Motoguzzi391/main_project/Jeff/Report/Robotics_Control/Screenshots/gripper.PNG

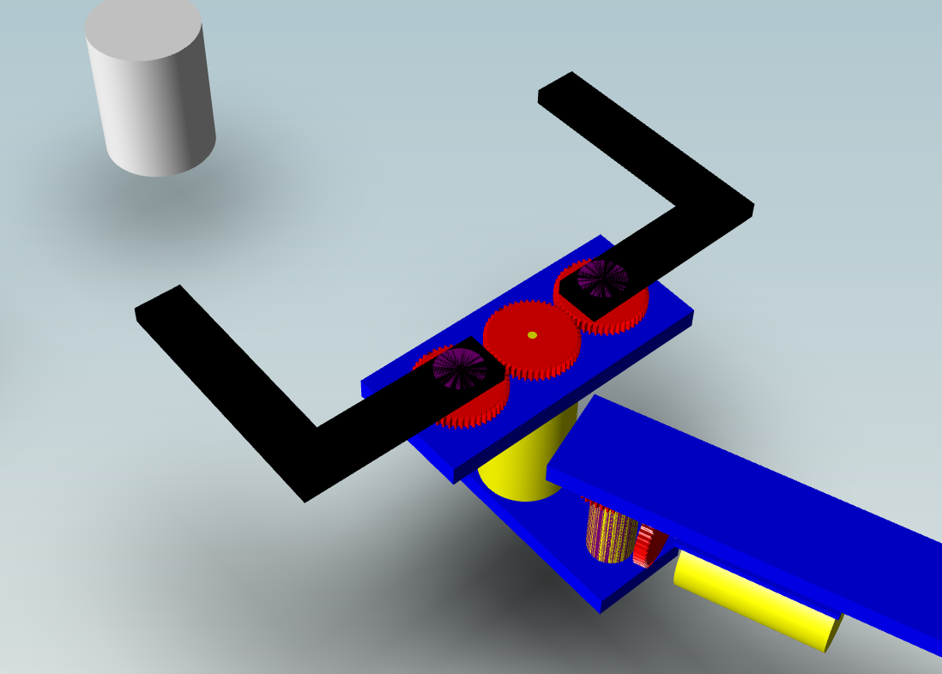
Jeff/Report/Robotics_Control/Screenshots/gripper.PNG
