Motoguzzi391/main_project/Jeff/Report/Robotics_Control/Screenshots/3.PNG

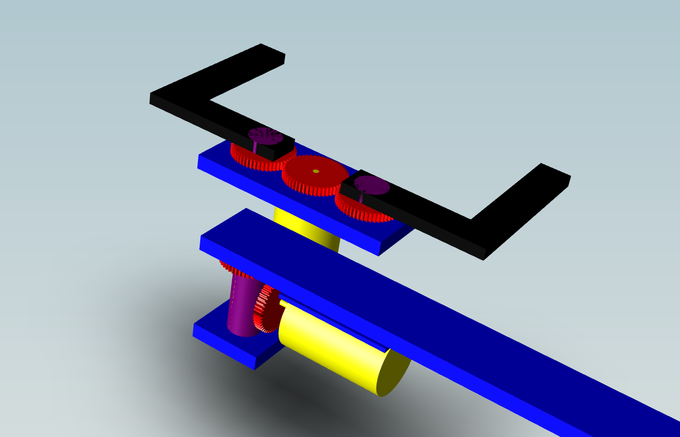
Jeff/Report/Robotics_Control/Screenshots/3.PNG
