Motoguzzi391/main_project/Jeff/Report/Robotics_Control/Screenshots/2.PNG

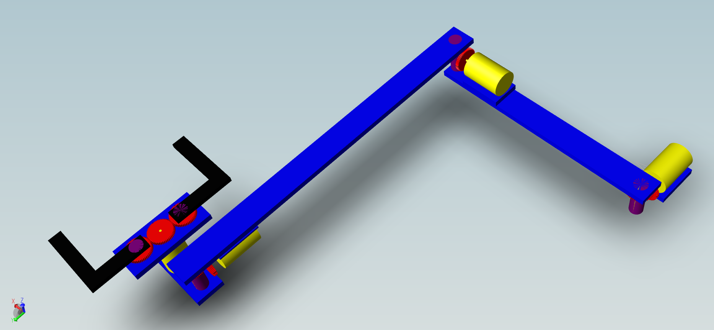
Jeff/Report/Robotics_Control/Screenshots/2.PNG
