Motoguzzi391/main_project/Jeff/Report/Robotics_Control/Screenshots/Screen Shot 2021-04-13 at 8.36.03 PM.png

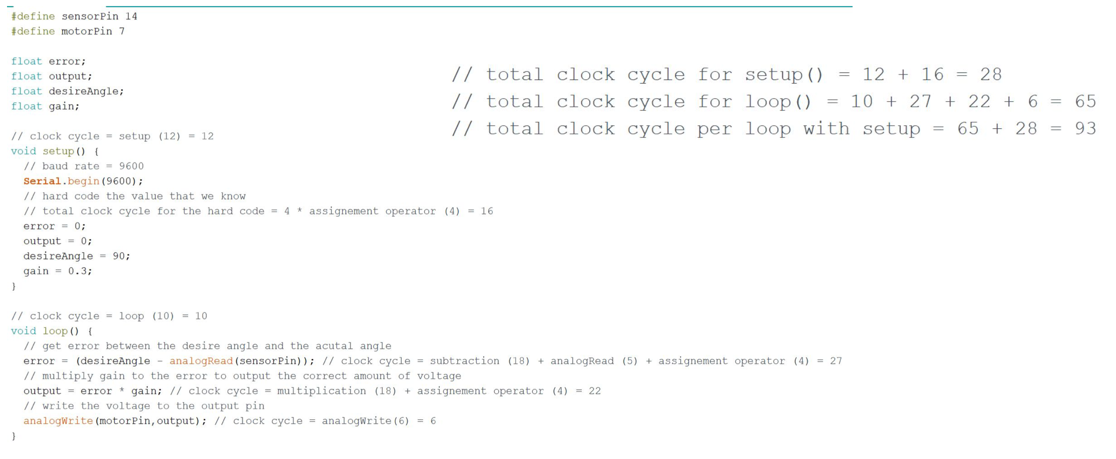
Jeff/Report/Robotics_Control/Screenshots/Screen Shot 2021-04-13 at 8.36.03 PM.png
