Motoguzzi391/main_project/Mark/elec/Driver_Circuit.jpg

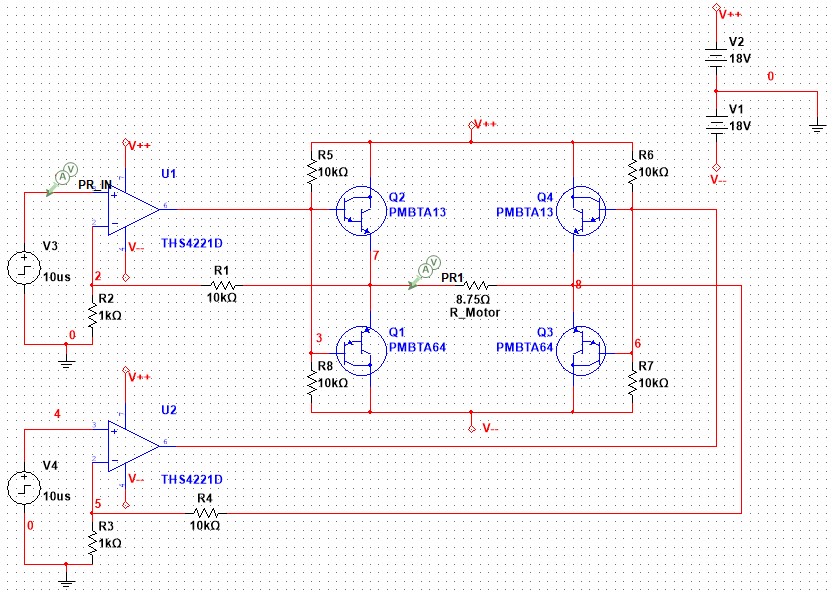
Mark/elec/Driver_Circuit.jpg
