Motoguzzi391/main_project/Mark/elec/Negative_Transient_Differential.jpg

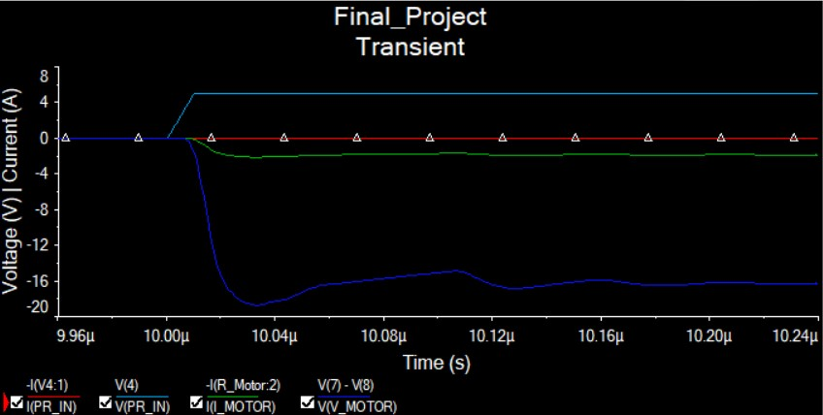
Mark/elec/Negative_Transient_Differential.jpg
