Motoguzzi391/main_project/Mark/elec/PCB_2D_View.jpg

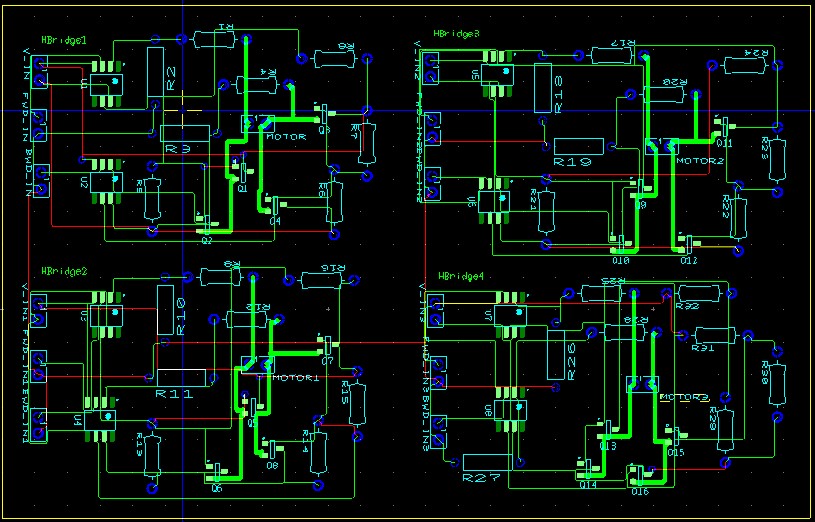
Mark/elec/PCB_2D_View.jpg
