Motoguzzi391/main_project/Mark/elec/PCB_3D_View.jpg

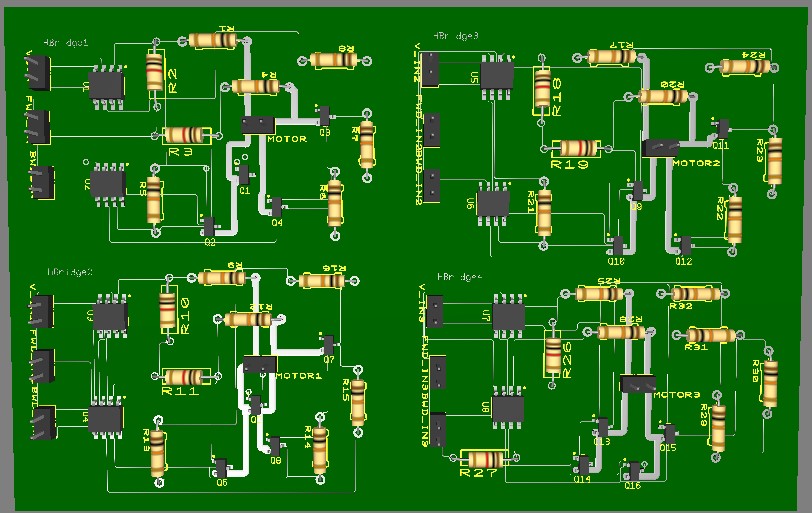
Mark/elec/PCB_3D_View.jpg
