Motoguzzi391/main_project/Mark/elec/Positive_Transient.jpg

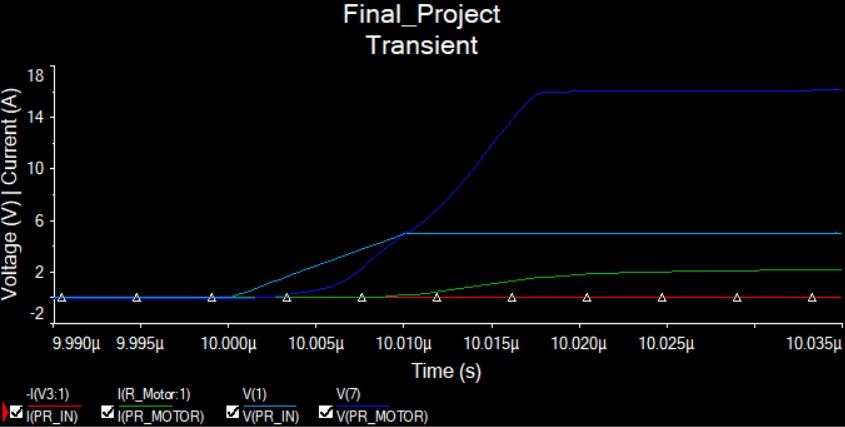
Mark/elec/Positive_Transient.jpg
