Motoguzzi391/main_project/Mark/elec/Transfer_Function.jpg

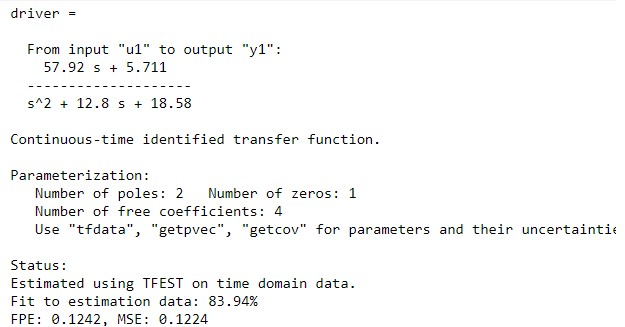
Mark/elec/Transfer_Function.jpg
