Motoguzzi391/main_project/Mark/mech/Maxon_Catalog_18V_Motor.jpg

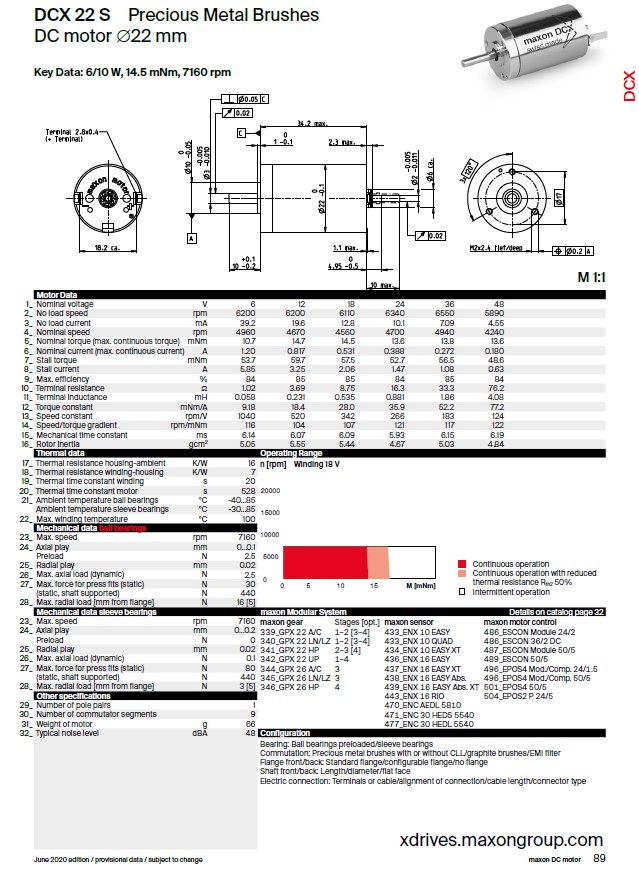
Mark/mech/Maxon_Catalog_18V_Motor.jpg
