Motoguzzi391/main_project/Jeff/Solidworks/gripper/assem1.SLDASM

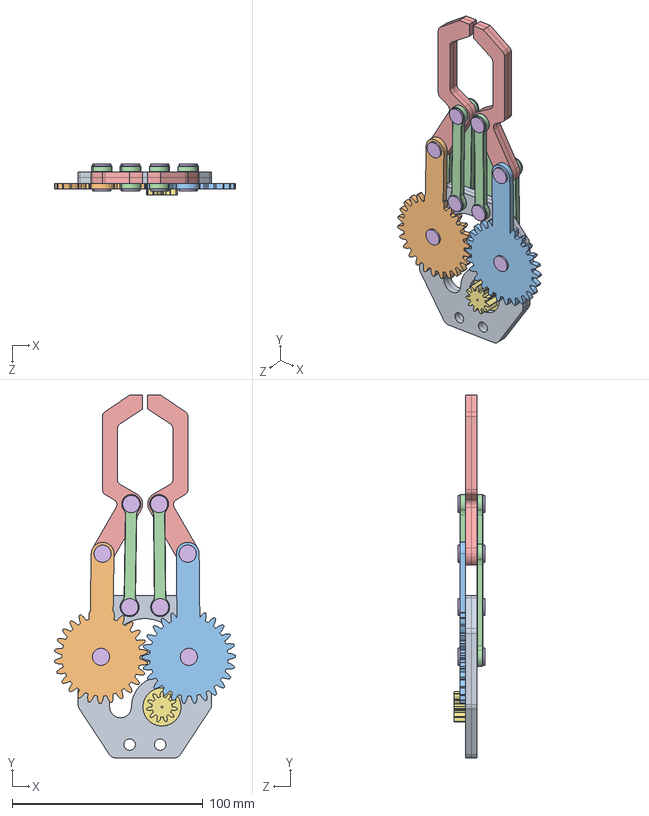
[picture p77: CAD file, 2021-04-15]
Jeff/Solidworks/gripper/assem1.SLDASM
94.9 x 190.1 x 16.0 mm
new_gear1
new_gear
joint1 x 6
joint2 x 8
final-special_gear
