Motoguzzi391/main_project/Grace/final-special_gear.SLDPRT

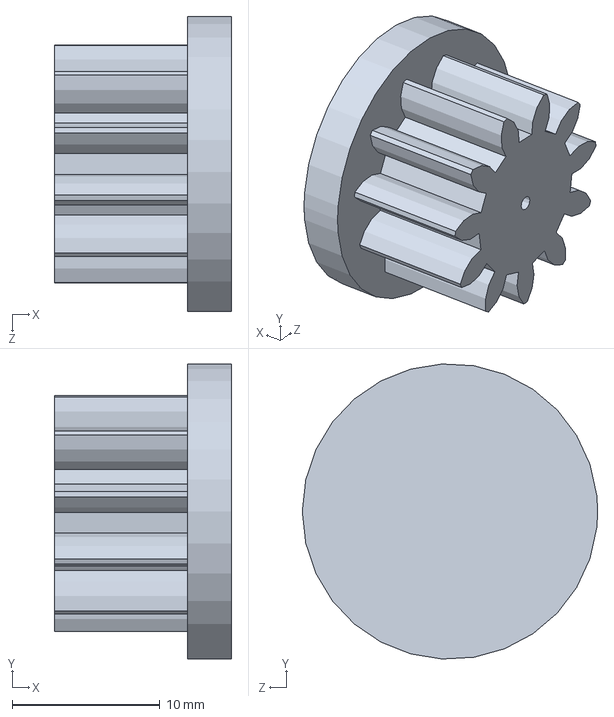
[picture p78: CAD file, 2021-04-15]
Grace/final-special_gear.SLDPRT
12.0 x 20.0 x 20.0 mm
