Motoguzzi391/main_project/Jeff/Solidworks/gripper/gripper - joint2-6.STL

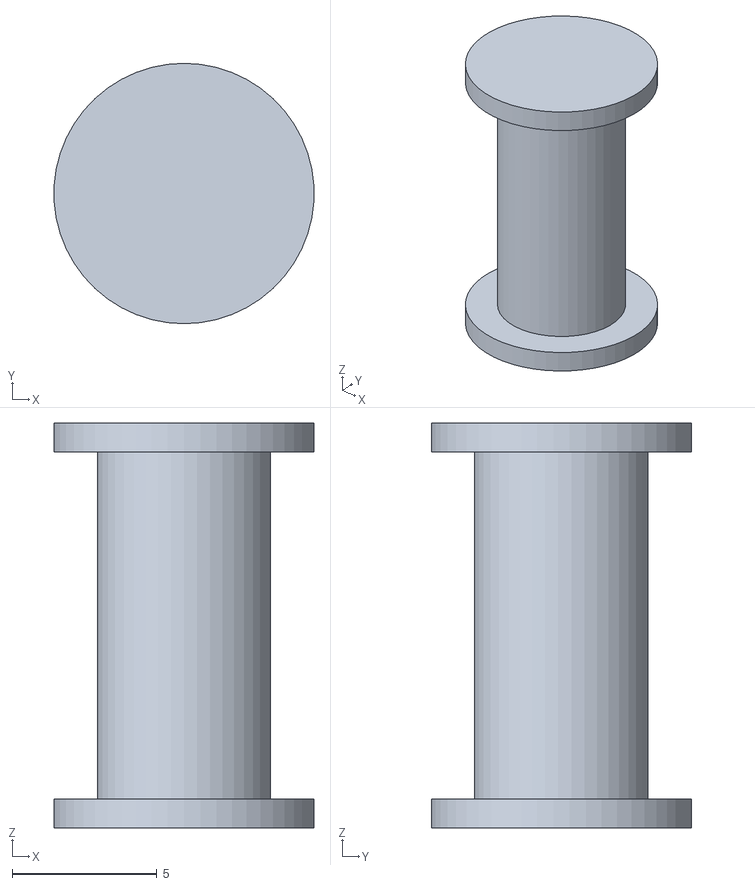
[picture p79: CAD file, 2021-04-15]
Jeff/Solidworks/gripper/gripper - joint2-6.STL
8.98 x 9.00 x 14.0
