Motoguzzi391/main_project/Mark/elec/Ultiboard_CAD_Export.dxf

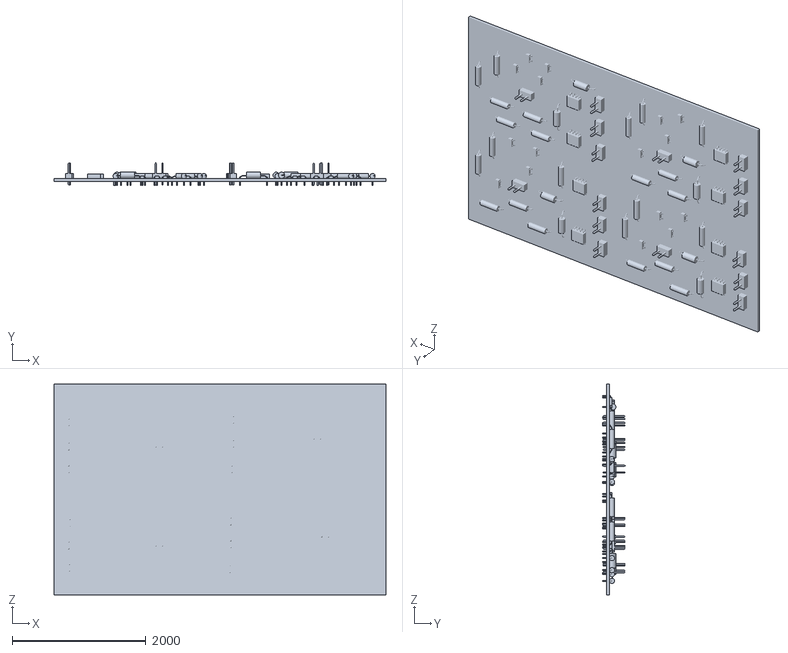
[picture p80: CAD file, 2021-04-15]
Mark/elec/Ultiboard_CAD_Export.dxf
4960.1 x 336.6 x 3150.0
