Motoguzzi391/main_project/Mark/mech/Motor_Model.stp

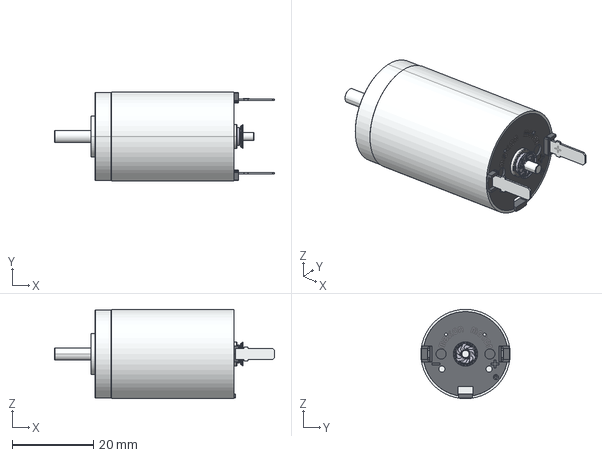
[picture p81: CAD file, 2021-04-15]
Mark/mech/Motor_Model.stp
54.2 x 22.0 x 22.0 mm
