Motoguzzi391/main_project/Grace/joint1.SLDPRT

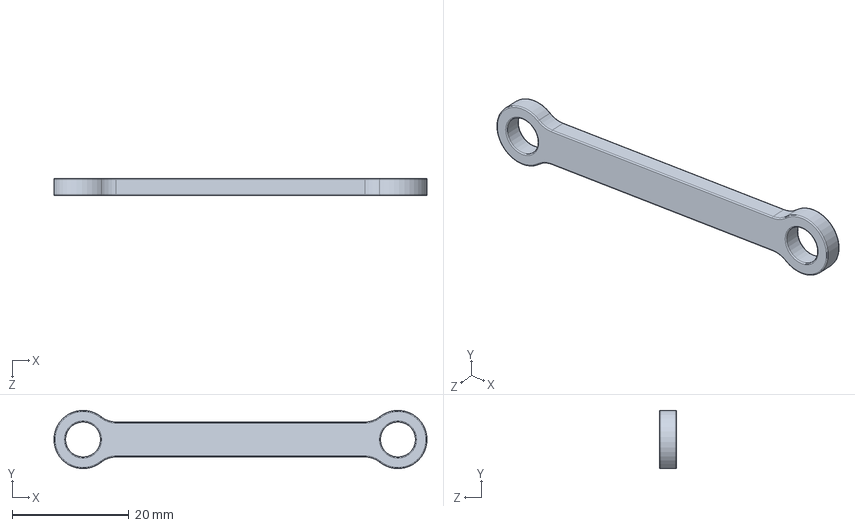
[picture p82: CAD file, 2021-04-15]
Grace/joint1.SLDPRT
64.0 x 9.99 x 3.00 mm
