Motoguzzi391/main_project/Mark/mech/Arduino Leonardo.STEP

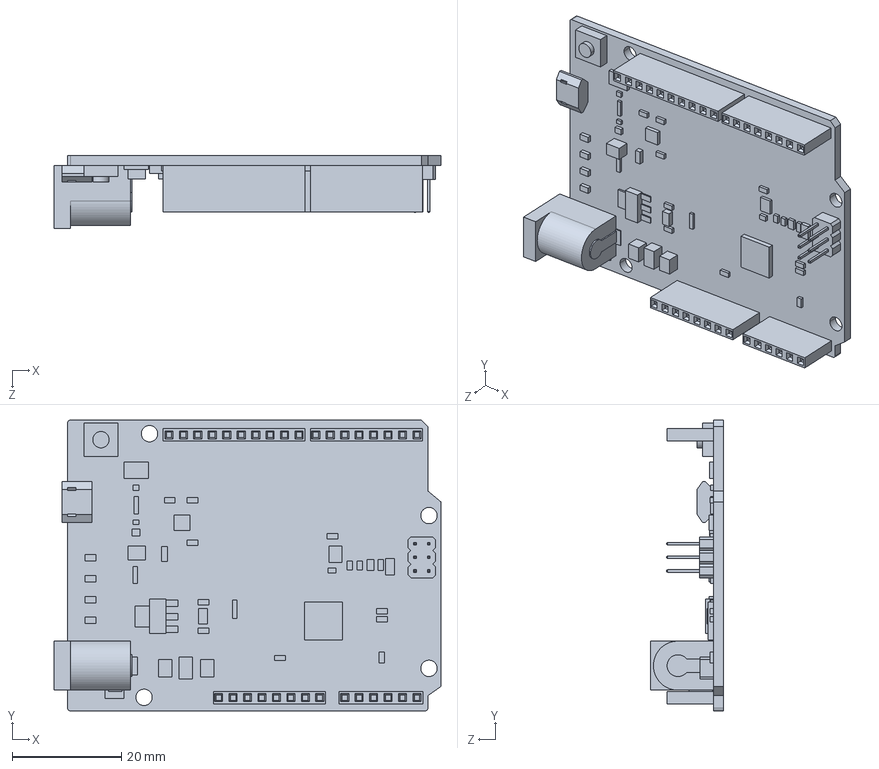
[picture p83: CAD file, 2021-04-15]
Mark/mech/Arduino Leonardo.STEP
70.9 x 53.3 x 13.3 mm
