Motoguzzi391/main_project/Grace/new_gear1.SLDPRT

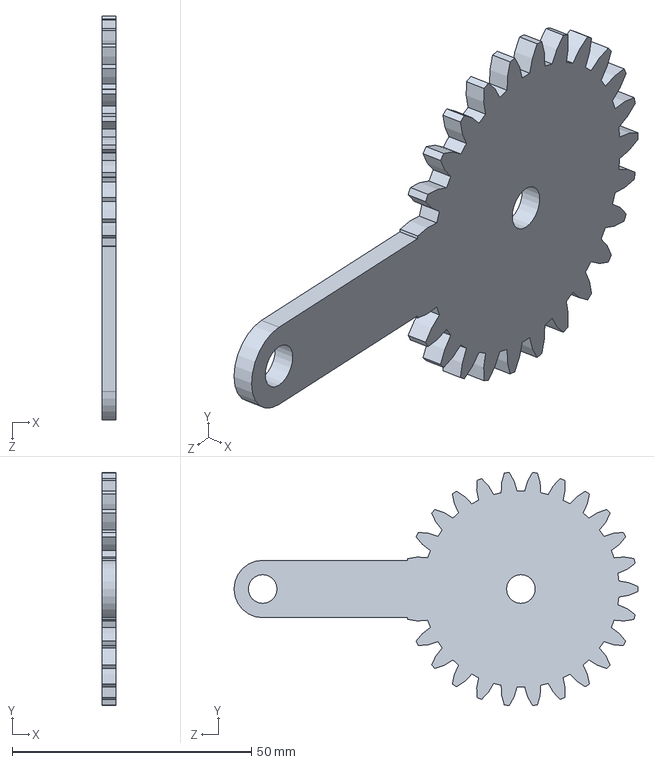
[picture p84: CAD file, 2021-04-15]
Grace/new_gear1.SLDPRT
3.00 x 48.8 x 84.5 mm
