Motoguzzi391/main_project/Jeff/Solidworks/gripper/gripper - spur gear_iso-1.STL

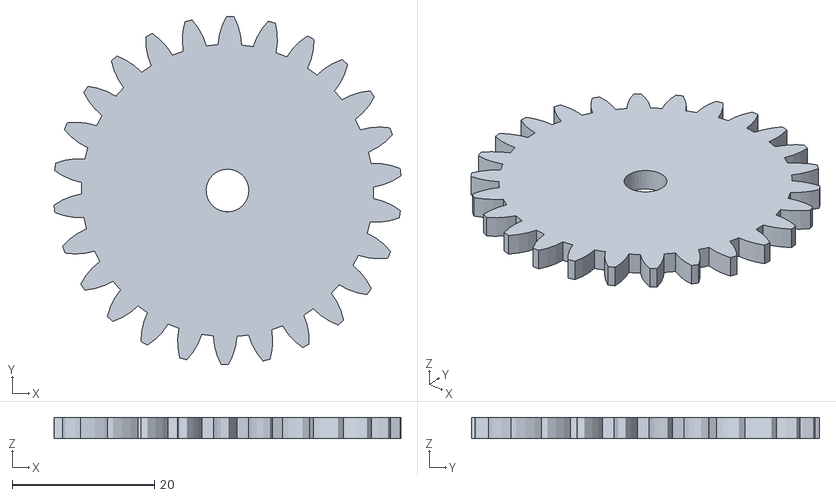
[picture p85: CAD file, 2021-04-15]
Jeff/Solidworks/gripper/gripper - spur gear_iso-1.STL
48.8 x 49.0 x 3.00
