Motoguzzi391/main_project/Grace/Part1.SLDPRT

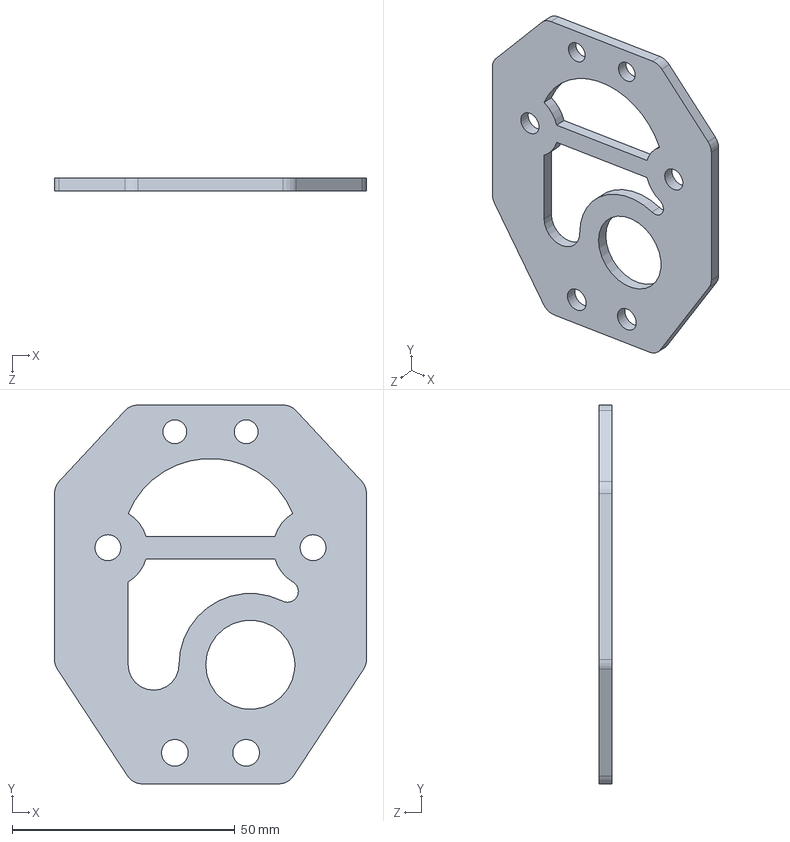
[picture p86: CAD file, 2021-04-15]
Grace/Part1.SLDPRT
70.0 x 85.0 x 3.00 mm
