Motoguzzi391/main_project/Jeff/Solidworks/gripper/gripper - joint1-6.STL

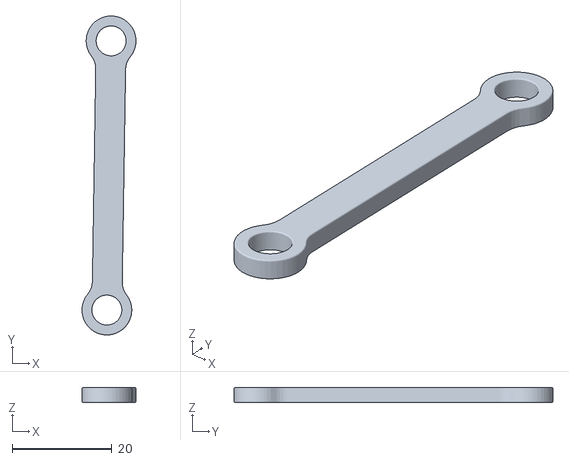
[picture p87: CAD file, 2021-04-15]
Jeff/Solidworks/gripper/gripper - joint1-6.STL
10.8 x 64.0 x 3.00
