Motoguzzi391/main_project/Grace/Part2.SLDPRT

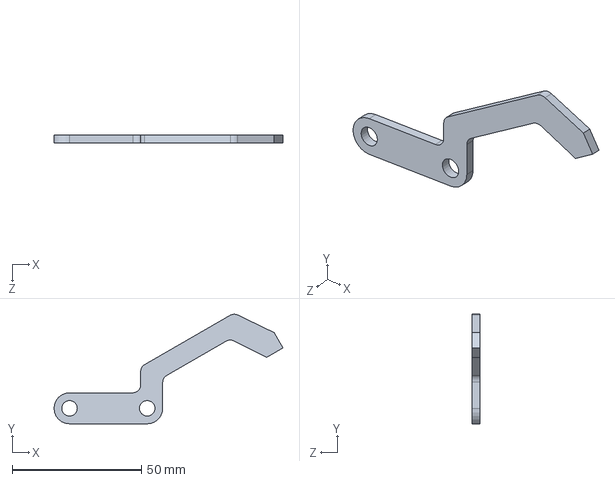
[picture p88: CAD file, 2021-04-15]
Grace/Part2.SLDPRT
88.5 x 42.4 x 3.00 mm
