Motoguzzi391/main_project/Jeff/Solidworks/gripper/gripper - Part2-5.STL

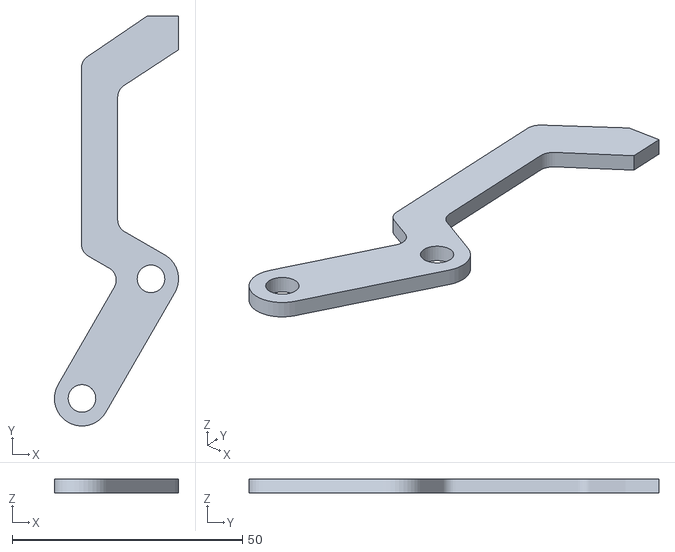
[picture p89: CAD file, 2021-04-15]
Jeff/Solidworks/gripper/gripper - Part2-5.STL
27.0 x 89.1 x 3.00
