Motoguzzi391/main_project/Jeff/Solidworks/gripper/gripper - spur gear_iso-4.STL

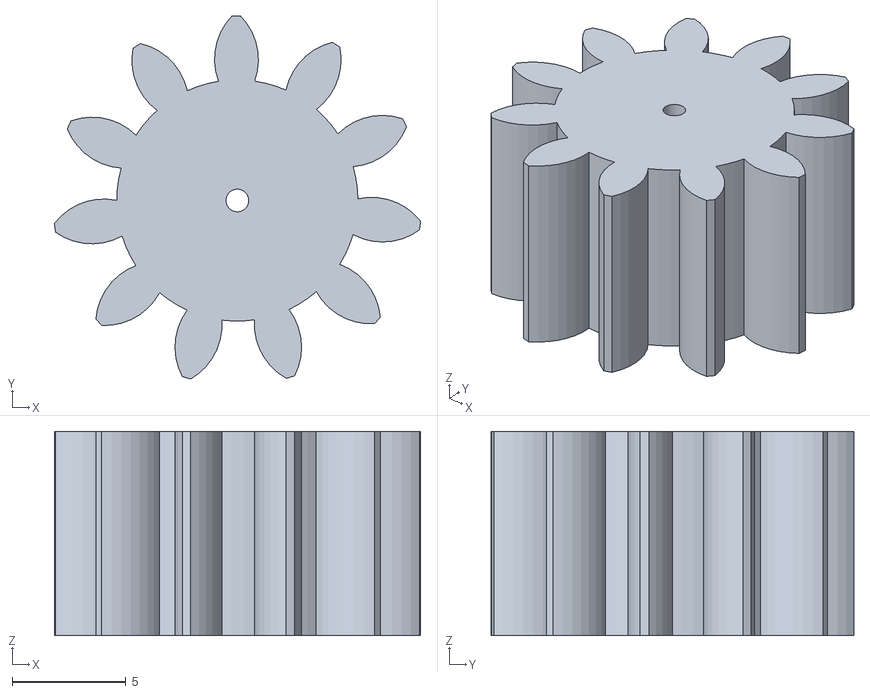
[picture p90: CAD file, 2021-04-15]
Jeff/Solidworks/gripper/gripper - spur gear_iso-4.STL
16.1 x 16.0 x 9.00
