Motoguzzi391/main_project/(list of files, cad)

Other CAD files:
Grace/joint2.SLDPRT
Jeff/Solidworks/gripper/joint2.SLDPRT
Grace/new_gear.SLDPRT
Jeff/Solidworks/gripper/gripper - joint1-4.STL
Jeff/Solidworks/gripper/gripper - joint2-3.STL
Jeff/Solidworks/gripper/gripper - Part1-2.STL
Jeff/Solidworks/gripper/gripper - Part2-6.STL
Jeff/Solidworks/gripper/gripper - joint1-3.STL
Jeff/Solidworks/gripper/gripper - joint2-7.STL
Jeff/Solidworks/gripper/gripper - joint1-2.STL
Jeff/Solidworks/gripper/gripper - joint2-5.STL
Jeff/Solidworks/gripper/gripper - Part2-7.STL
Jeff/Solidworks/gripper/gripper - joint2-9.STL
Jeff/Solidworks/gripper/new_gear.SLDPRT
Jeff/Solidworks/gripper/gripper - Part2-4.STL
Jeff/Solidworks/gripper/gripper - Part1-1.STL
Jeff/Solidworks/gripper/gripper - spur gear_iso-3.STL
Jeff/Solidworks/gripper/gripper - joint2-1.STL
Jeff/Solidworks/gripper/gripper - joint1-5.STL
Jeff/Solidworks/gripper/gripper - joint2-8.STL
Jeff/Solidworks/gripper/gripper - joint1-1.STL
Jeff/Solidworks/gripper/gripper - joint2-4.STL
