Motoguzzi391/main_project/Mark/elec/Driver_Circuit.pdf

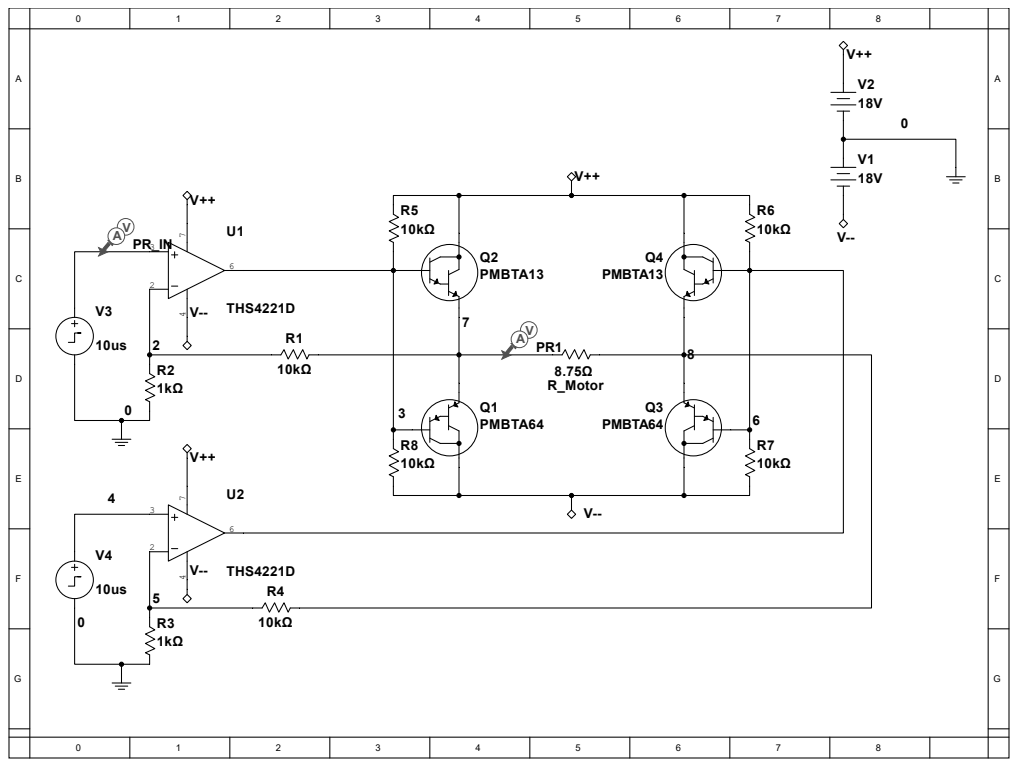
[picture p92: page 1]
