Motoguzzi391/main_project/(list of files, drawings)

Other design files:
Mark/elec/Final_Project.ms14
Mark/elec/Final_Project_PCB.ms14
