Motoguzzi391/main_project/(commit log)

2021-03-25 Robot Kinematics: Inverse Kinematics
    [Motor_pos.xlsx]
2021-04-08 motor specs & basic circuit
    [Arduino Leonardo.STEP, Driver_Circuit.ms14, HBridge.ms14, Jeff_Circuit.ms14, MOS_HBridge.ms14, Motor_Model.stp]
2021-04-08 h-bridge improvement and Tfest
    [Driver_Circuit.ms14, Final_Project.ms14, HBridge.ms14, Jeff_Circuit.ms14, MOS_HBridge.ms14, Transient_Response.csv]
2021-04-09 added in gripper motor to the simulink
    [Motor_pos.xlsx]
2021-04-09 Testing path with simx cosim with simulink
    [Motor_pos.xlsx]
2021-04-10 uploading simx and simulink with gripper
2021-04-11 PCB and Transients
    [Final_Project.ms14, Final_Project_PCB.ms14, Ultiboard_CAD_Export.dxf]
2021-04-11 Applied the gear design
2021-04-12 applied gear design
2021-04-12 Gear with gripper cosimulation ready
    [Part1.SLDPRT, Part2.SLDPRT, assem1.SLDASM, final-special_gear.SLDPRT, gripper - Part1-1.STL, gripper - Part1-2.STL, gripper - Part2-4.STL, gripper - Part2-5.STL]
2021-04-13 added PCB CAD model and images
    [Final_Project.ms14]
2021-04-13 added matlab pid in report
2021-04-15 deleting all videos due to size limit
    [Arduino Leonardo.STEP, Final_Project.ms14, Final_Project_PCB.ms14, Motor_Model.stp, Part1.SLDPRT, Part2.SLDPRT, Transient_Response.csv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]
